666-nailong/fpga-instrument-competition/比赛材料/作品海报/FPGA海报_架构框图与实物版.pdf

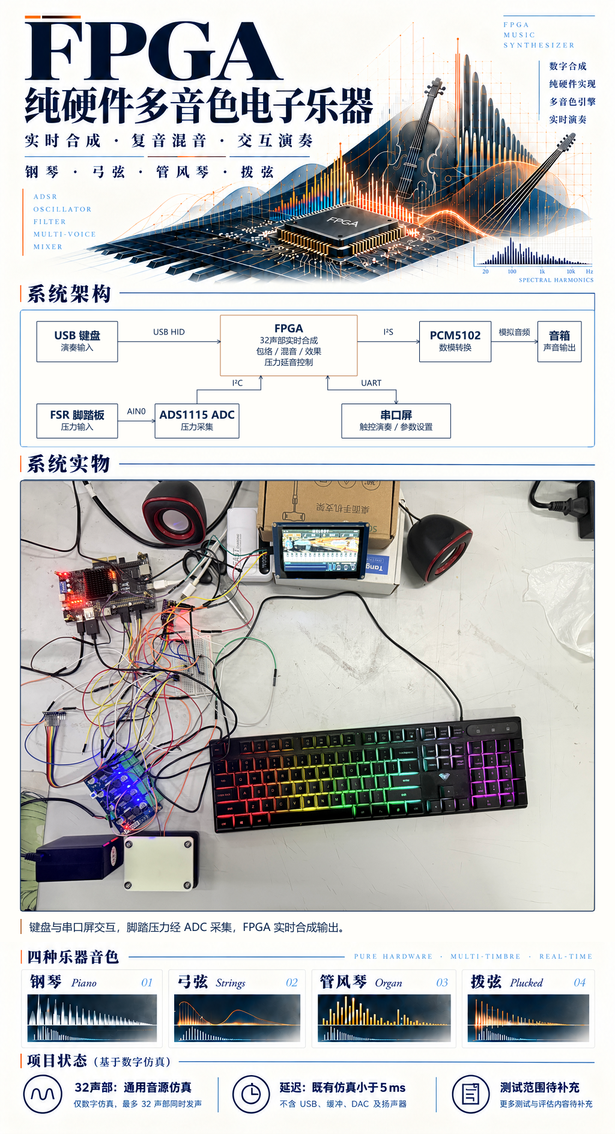
[picture p11: page 1]
