666-nailong/fpga-instrument-competition/比赛材料/参赛作品承诺及使用授权书/参赛作品承诺及使用授权书.pdf

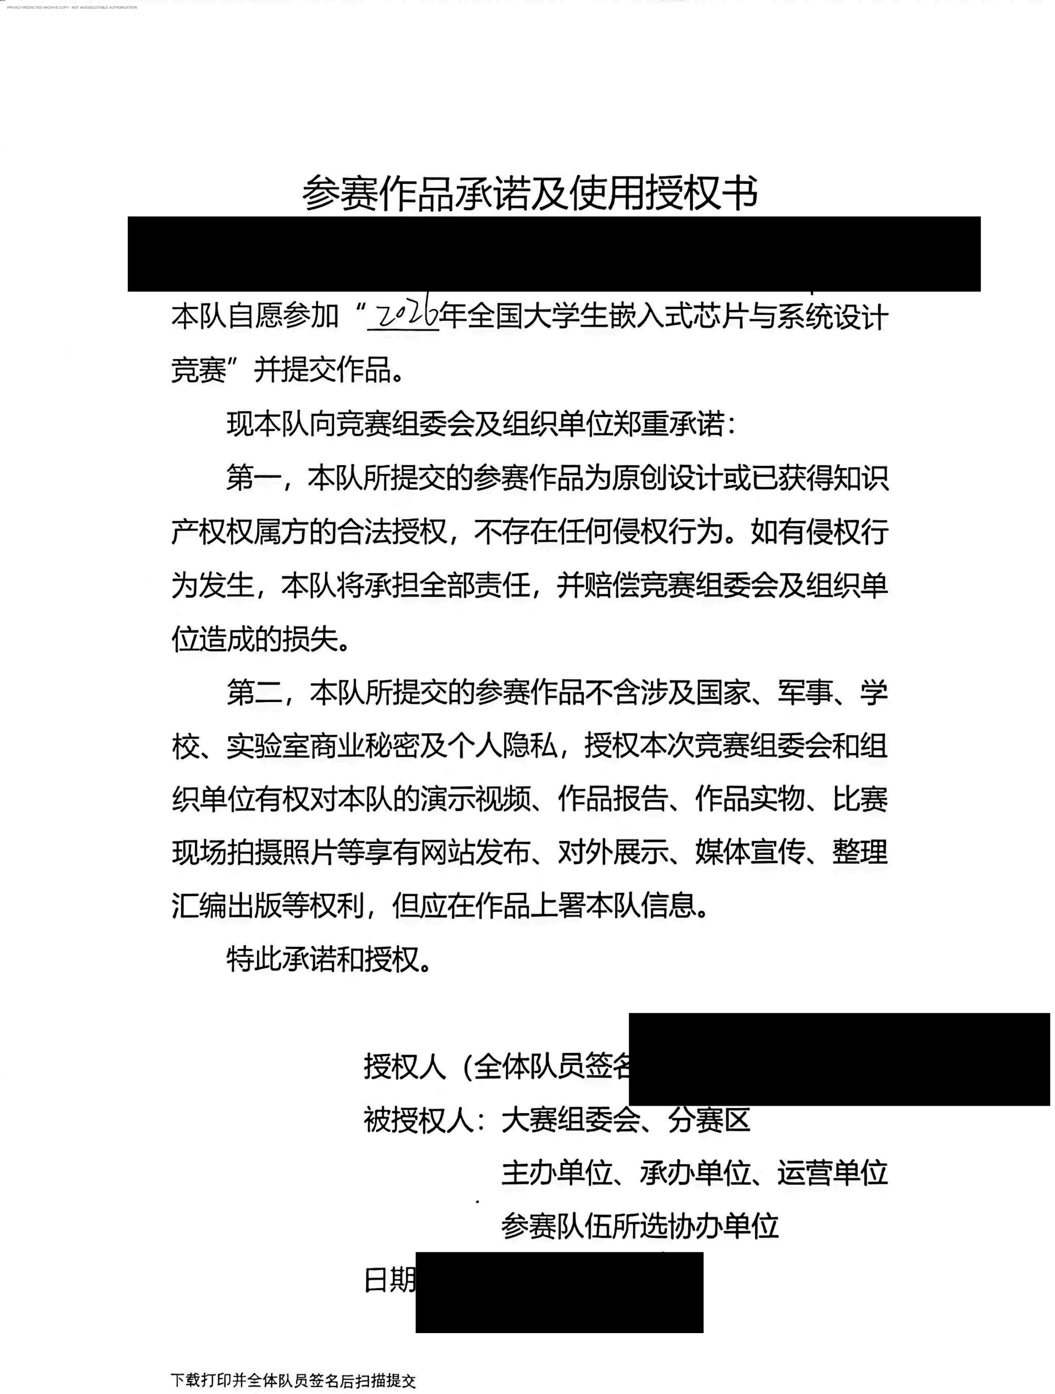
[picture p12: page 1]

PRIVACY-REDACTED ARCHIVE COPY - NOT AN EXECUTABLE AUTHORIZATION
