666-nailong/fpga-instrument-competition/脚踏板3D打印/exploded_preview.png

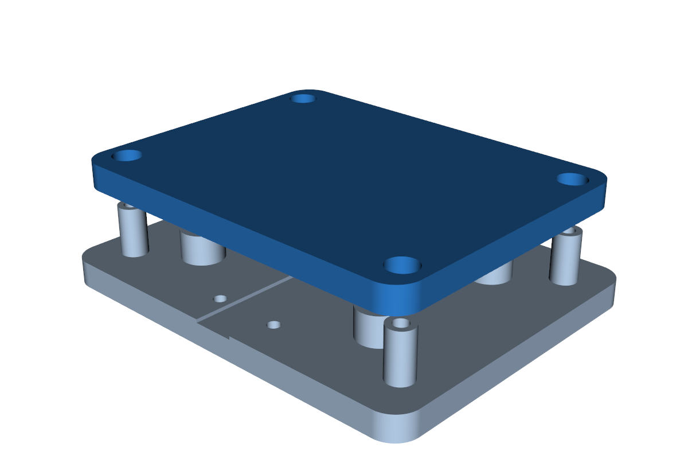
脚踏板3D打印/exploded_preview.png
