666-nailong/fpga-instrument-competition/脚踏板3D打印/tread_FSR402B.step

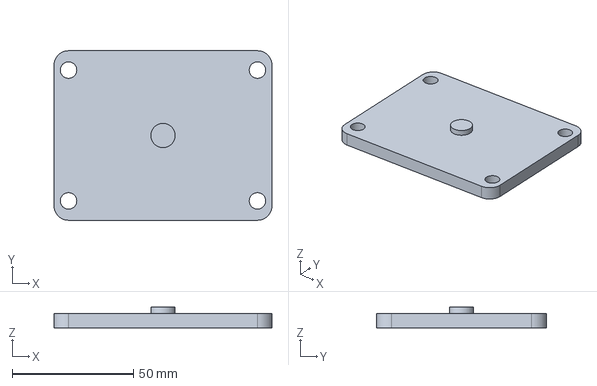
[picture p14: CAD file, 2026-11-04]
脚踏板3D打印/tread_FSR402B.step
90.0 x 70.0 x 8.50 mm
