666-nailong/fpga-instrument-competition/脚踏板3D打印/base_FSR402B.step

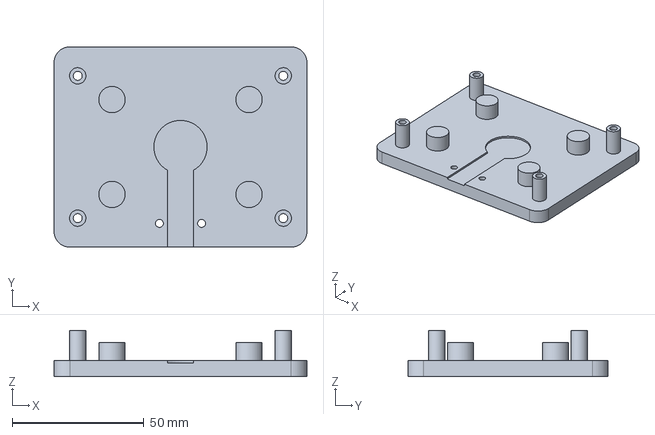
[picture p15: CAD file, 2026-11-04]
脚踏板3D打印/base_FSR402B.step
96.0 x 76.0 x 17.5 mm
