666-nailong/fpga-instrument-competition/(list of files, cad)

Other CAD files:
脚踏板3D打印/base_FSR402B.stl
脚踏板3D打印/tread_FSR402B.stl
