666-nailong/fpga-instrument-competition/脚踏板3D打印/打印与装配说明.md

# FSR402B 音量脚踏板：打印与装配

按用户照片中的 **FSR402B 短尾**设计：总长 25.00 mm，圆片 Ø18.00 mm，有效区 Ø14.70 mm，尾宽 7.62 mm，厚 0.375 mm；卖家提示实物可能差 0.5–1 mm。圆片放入浅槽，尾片始终走直线槽；压板中央 Ø10 mm 凸台经软垫向有效区施力，四个硬柱在压到底时承受脚踩负载。压板作直线升降，不需铰链。打印前用实物卡尺复核。

## 文件与主要尺寸

| 文件 | 内容 |
| --- | --- |
| `base_FSR402B.stl` / `.step` | 底座，**96 × 76 × 17.5 mm** 最大外包；板厚 6 mm，含导柱和限位柱 |
| `tread_FSR402B.stl` / `.step` | 活动压板，**90 × 70 × 8.5 mm** 最大外包；板厚 6 mm，含 2.5 mm 凸台 |
| `model.py` | 可修改尺寸并重新生成 STEP/STL 的 CadQuery 参数化源文件 |
| `drawing.py` | 生成尺寸图与 3D 爆炸预览的源文件 |
| `assembly_diagram.png` / `.svg` | 顶视和松脚状态剖面尺寸图 |
| `exploded_preview.png` | 两个打印件的 3D 爆炸预览 |

两个零件的 X/Y 尺寸都小于用户指定的免费打样 **100 × 100 mm** 边界。嘉立创 3D 打印当前支持 **STL（推荐）、STP、STEP、OBJ**，报价上传应把两个 STL **分别作为两个零件**提交，每个文件只有一个实体；页面还标示单文件 100 MB 限制。[嘉立创上传说明](https://jlc3dp.com/help/article/how-to-place-a-3d-printing-order)。STEP 用于修改、核对尺寸。

修改尺寸后可在装有 Python 与 CadQuery 2.8 的环境中，进入本目录依次运行 `python model.py`、`python drawing.py`，重新生成零件和图。压缩包是便于保存的合集；**报价时上传独立 STL，不上传压缩包**。

结构尺寸：传感器槽 Ø20.2、深 0.8 mm；尾槽宽 9.8 mm、与圆槽同底面并通至底座边；压板导向孔 Ø6.8、导柱 Ø6.2；四个限位柱顶高 z=13 mm。压板松脚时底面调至 z≈15 mm，踏下 **2 mm** 即碰限位。软垫先裁 Ø10 × 7 mm，粘在凸台底面。照片中的有效区 Ø14.7，因此 Ø10 压头保留 2.35 mm 径向余量。

## 另购件与淘宝核对入口

下列是已找到的淘宝/天猫商品**参考入口**，多数链接先到商品索引页，可点击页面“前往购买”进入淘宝；购买时选择表中规格，勿只按商品标题下单。库存、变体和实物公差以店铺页面为准。部分索引页带有数字商品 ID，也列出由该 ID 拼出的[淘宝直达链接](https://item.taobao.com/)供核对；淘宝页面在当前检索环境无法直接读取。

| 物品 | 数量与需选规格 | 淘宝商品参考入口 |
| --- | --- | --- |
| 压缩弹簧 | 4 根，外径约 10 mm、线径约 0.5 mm、自由长 **10 mm**；内径须 >6.2 mm，压至 7 mm 时不可并圈 | [淘宝直达，核对 0.5/10/10 变体](https://item.taobao.com/item.htm?id=19460009510) · [商品索引](https://tao.hooos.com/goods_19460009510.html) |
| 圆柱头机牙螺丝 | 4 颗，**M3 × 25 mm**、全牙优先；不要买自攻螺丝 | [M3/M4 等内六角机牙螺丝，选 M3×25](https://tao.hooos.com/goods_qkK97Xdjs2t4bG63k0BTg3dsWt0-OpRwwaFxVmWPb6BT9.html) |
| 加大平垫 | 4 片，M3 孔，外径 **≥9 mm**，必须跨过压板 Ø6.8 孔 | [淘宝直达，选 DIN9021 M3](https://item.taobao.com/item.htm?id=653058840580) · [商品索引](https://tao.hooos.com/goods_653058840580.html) |
| 普通六角螺母 | 4 颗，M3，实测对边 **≤5.8 mm**、高 **≤2.7 mm**；底座六角沉孔按对边约 5.9 mm 做，不适合高尼龙锁紧螺母或法兰螺母 | [淘宝搜索：M3 普通六角螺母](https://s.taobao.com/search?q=M3%20%E6%99%AE%E9%80%9A%E5%85%AD%E8%A7%92%E8%9E%BA%E6%AF%8D) |
| 软施力垫 | 1 片，低硬度**开孔海绵/软泡棉**，裁成 Ø10 × 7 mm；可买 8–10 mm 板材后裁薄；不要用硬 EVA 或硬 TPU 实心柱直接压 FSR | [淘宝搜索：开孔 PU 软海绵 10mm](https://s.taobao.com/search?q=%E5%BC%80%E5%AD%94PU%E8%BD%AF%E6%B5%B7%E7%BB%B5%2010mm) |
| 底部防滑脚垫 | 4 片，直径约 10–15 mm、**高 ≥6 mm**，给 M3×25 螺丝端头留离地间隙 | [淘宝直达，选高 ≥6 mm](https://item.taobao.com/item.htm?id=626062804142) · [商品索引](https://tao.hooos.com/goods_626062804142.html) |
| 扎带、绝缘导线 | 2.5 mm 宽扎带 1 根；两芯软导线和与控制板 J3 匹配的线束端子 1 套 | [2.5×100 mm 扎带参考](https://tao.hooos.com/goods_dkGjGjJtZt0GZbGhjoPcet3-VeR99wckn2gbNVtR.html) |

FSR 两个金属尾针的间距和端子形式须按收到的实物选。**不要把胶带/扎带压在薄膜尾片或气孔上，也不要焊接薄膜上的银浆线路**；只有实物确认是独立金属焊片时才按其供应商说明焊线，优先采用匹配的夹持/插接端子。Interlink 的[集成指南](https://www.interlinkelectronics.com/downloads/integration-guides/fsr-400-series-integration-guide.pdf)明确提醒尾部不要折皱、不要堵排气通道。

## 打印与装配

1. 推荐 PETG 或 PA12；若选嘉立创服务，在页面核对所选材料对最小孔径/间隙的要求。家用 FDM 参考 0.2 mm 层高、4 道墙、35% 以上填充。两件均按 STL 现有朝向摆放：底座大平面朝下；压板**鞋底接触面朝下、凸台朝上**打印，装配时翻转。所有导向孔去毛刺，确保 Ø6.2 导柱在 Ø6.8 孔内滑动。
2. 底座下方四个六角孔装入普通 M3 螺母。FSR 圆片平放在中央槽，尾片向 -Y 方向直线引出；只在圆片外缘轻贴定位胶带，保留气孔。两根软线在尾槽远端转接，直到导线已有绝缘外皮的位置，再用穿过 x=±8、y=-29 两个孔的扎带做应力释放，勿勒尾片。
3. 在压板凸台端面固定软垫，初始厚度 7 mm。四根弹簧套在底座 Ø6.2 导柱外，翻转压板使凸台朝下，四孔对准导柱。M3×25 螺丝经加大平垫、压板孔、导柱孔拧入底部螺母，四角均匀调节，**松脚时压板底面高出底座顶面约 9 mm**（即绝对 z≈15 mm）。此时弹簧从 10 mm 自由长压至约 9 mm，导柱保持插入压板孔约 2.5 mm。
4. 底部四角贴高 ≥6 mm 防滑脚垫；压板顶面贴防滑橡胶面。检查上下活动顺滑，四个限位柱能在压板下降 2 mm 后同时接触，底部螺丝端头不触地。
5. **先不用脚踩。** 用手和小型力计/秤压到硬限位，确认中央软垫的局部反力在目标范围内，建议先按 **≤10 N** 试配；软垫过硬、释放时已有预压或四角不同步，就换软垫/微调螺丝。接入 ADS1115 后检查读数随按压力平滑变化、松脚复位，再进行轻踩调试。FSR 标称 0.2–20 N 是 Interlink 402 的**感测范围而非此兼容件的损坏阈值**，实际受力必须通过所购软垫和样件验证。[Interlink 402 产品页](https://www.interlinkelectronics.com/products/fsr-402-short)

## 电路对应

项目控制页为 `+3V3 → FSR → PRESSURE_AIN0 → 10 kΩ(R1) → GND`，ADS1115 AIN0 读取电压，再交给 `expression_ctrl.v` 调整整体音量。当前 RTL 的表达值下限为 64，因此松脚不会完全静音；若要零音量，需另行改 RTL 并对实际脚踏读数标定。现有 16 键矩阵 PCB 不包含控制页的 J3/R1/ADS1115，机械件可先打印试装，完整接线要使用相应控制电路。
