666-nailong/fpga-instrument-competition/脚踏板3D打印/assembly_diagram.png

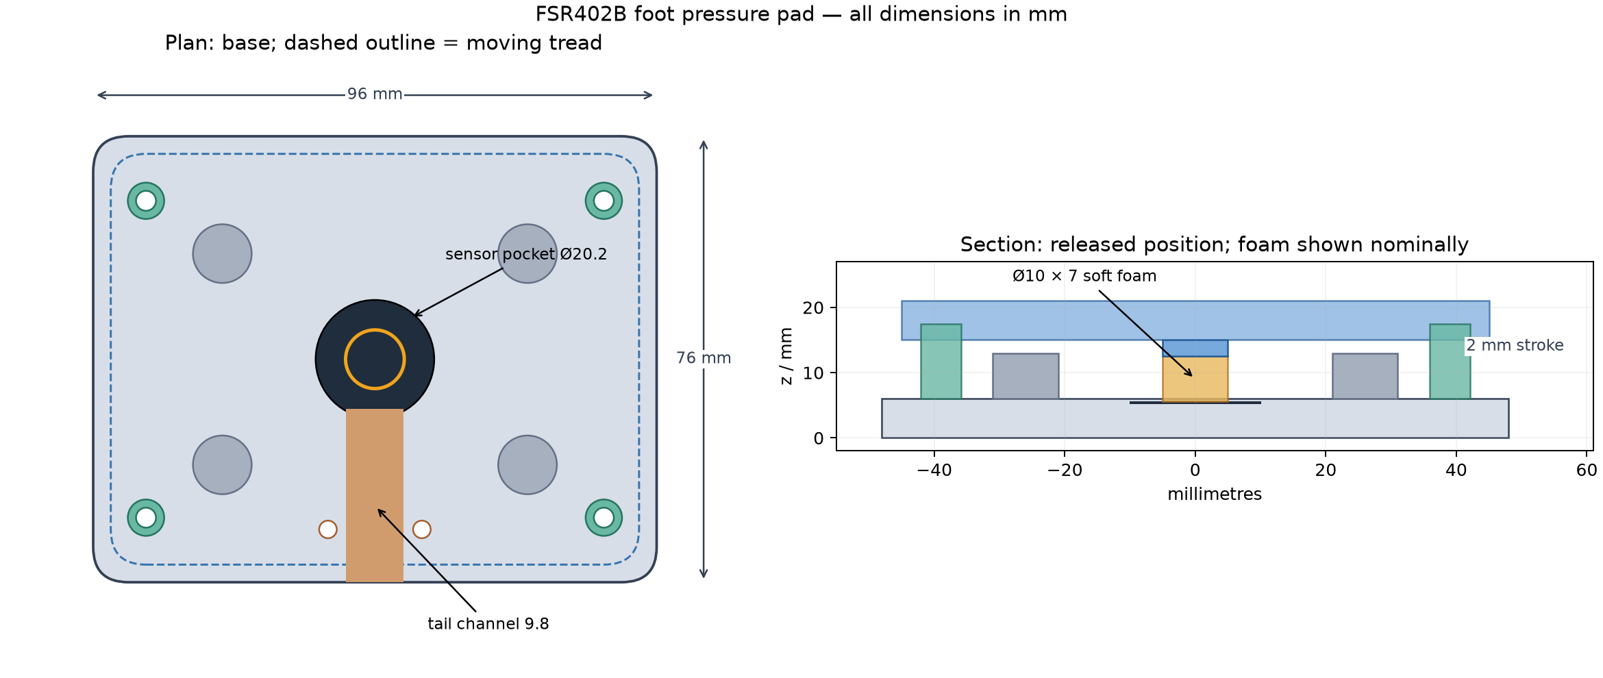
脚踏板3D打印/assembly_diagram.png
