666-nailong/fpga-instrument-competition/源代码/FPGA_Instrument_r20/FPGA/sim/models/usb_pll_model.v

`timescale 1ns/1ps
// Functional clock only; not a PLL/electrical USB enumeration simulation.
module usb_pll_50_to_60(input wire clkin,output reg clkout=0,output reg lock=0);
    always #8.333333 clkout=~clkout;
    initial begin repeat(8)@(posedge clkin);lock=1;end
endmodule
